davegutz/myThermostat-Particle-Photon/photos/view_of_mechanical_2015-09-09 14.54.21.jpg

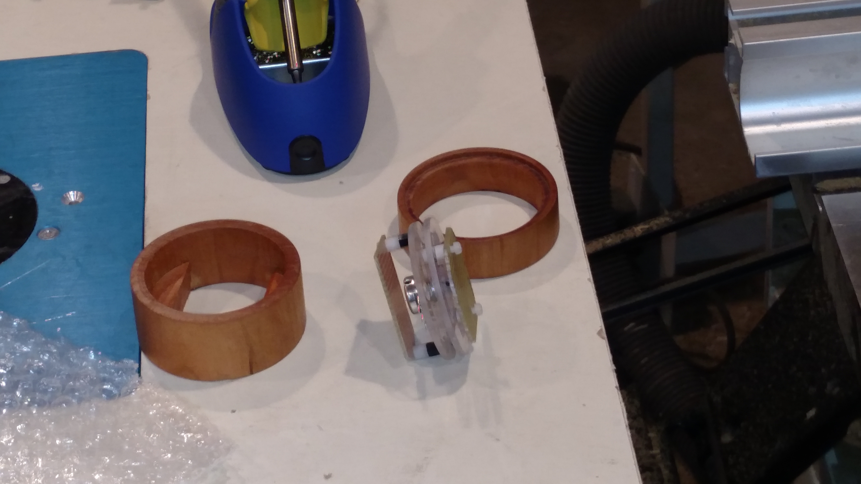
photos/view_of_mechanical_2015-09-09 14.54.21.jpg
