davegutz/myThermostat-Particle-Photon/photos/Working_Photo_IMG_7496.JPG

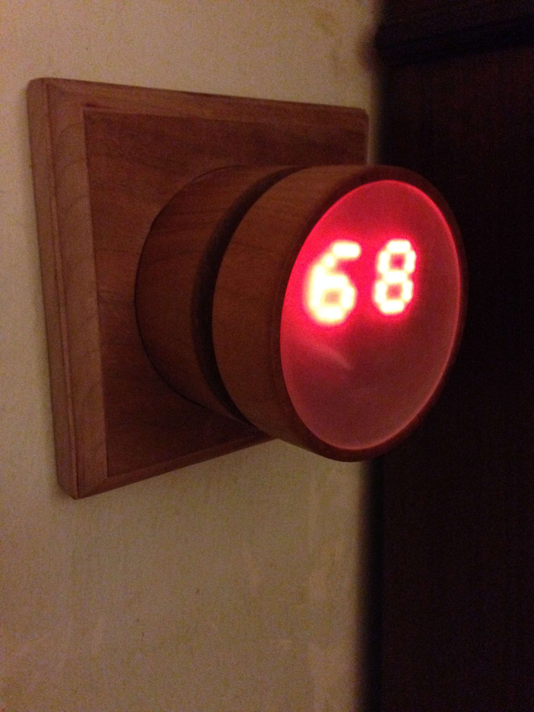
photos/Working_Photo_IMG_7496.JPG
