davegutz/myThermostat-Particle-Photon/schematics/PhotonThermostatLayout.ods

Sheet: Reed SIP Version
 |  |  |  |  |  |  |  |  |  |  |  |  |  |  |  |  |  |  |  |  |  |  |  |  |  |  |  |  |  | Furnace
 |  |  |  |  |  |  |  |  |  |  |  |  |  |  |  |  |  |  |  |  |  |  |  |  |  |  |  |  |  | 1 |  | J-TB4-S32 |  | R
 |  |  | J |  | J30 |  |  | 1-VIN |  |  | 3V3 |  | 24 | J |  | TB7 |  |  |  |  |  |  |  |  |  |  |  |  |  | 2 |  | J-TB4-S33 |  | W
K1 |  |  |  |  | J | e | J31 | 2-GND |  |  | RST |  | 23 | J24 |  | S | --
 | c25 |  | J |  | T1 |  |  | 3-TX |  |  | 3V3 |  | 22 | J24 |  | S | --
 |  |  |  |  | b | 29 |  | 4-RX |  | P1 | GND |  | 21 | J31 |  | S | --
L | J |  |  |  |  | R1 |  | 5-A7 |  |  |  | D7 | 20 | J2 |  | S | -- | PCBs & BreadboardsStripBoard-2, 1 side 80x100mm
 |  |  |  |  |  | Jll |  | 6-A6 |  |  |  | D6 | 19 | J10 |  | S | -- |  |  |  |  |  |  |  |  |  |  |  |  | Rheostat
- | J25 | J26 |  | J28 |  |  |  | 7-A5 |  |  |  | D5 | 18 | J14 |  | S | -- |  |  |  |  |  |  |  |  |  |  |  |  | 1 |  |  | J-TB7-S1orS2
 |  |  |  |  |  |  |  | 8-A4 |  |  |  | D4 | 17 | J13 |  | S | -- |  |  |  |  |  |  |  |  |  |  |  |  | 2 |  |  | J-TB7-S5
+ | J1 |  | S32 |  | -- | JL |  | 9-A3 |  |  |  | D3 | 16 |  |  |  |  |  |  |  |  |  |  |  |  |  |  |  |  | 3 |  |  | J-TB7-S3orS4
 | JL |  | S33 |  | -- |  | J | 10-A2 |  |  |  | D2 | 15 |  |  |  |  |  |  |  |  |  |  |  |  |  |  |  |  | R6
L | J |  | S30 |  | -- | J | J | 11-A1 |  |  |  | D1 | 14 | J
 |  |  | S31 |  | -- | J |  | 12-A0 |  |  |  | D0 | 13 | J
 |  |  |  |  |  |  |  |  |  |  |  |  |  |  |  |  |  |  |  |  |  |  |  |  |  |  |  |  | R2 |  | Pull up resistor for I2C bus 4.7k RC1472KB
 |  |  |  |  |  |  |  |  |  |  |  |  |  |  |  |  |  |  |  |  |  |  |  |  |  |  |  |  | R3 |  | Pull up resistor for I2C bus 4.7k RC1472KB
 |  |  |  |  |  |  |  |  |  |  |  |  |  |  |  |  |  |  |  |  |  |  |  |  |  |  |  |  | TB4 |  | 4-pin terminal block 1725672 4P 2.54mm 90DEG
 |  |  |  |  |  |  |  |  |  |  |  |  | C |  | SCL |  |  |  |  |  | J |  | S9 |  | JR2 |  |  | J-TB7-S6 | S |  | screw
 |  |  |  |  |  |  |  |  |  |  |  |  | D |  | SDA |  |  |  |  |  | J |  | S10 |  | JR3 |  |  | J-TB7-S7 | TB7 |  | 7-pin terminal block 1725708 7P 2.54mm 90DEG
 |  |  |  |  |  |  |  |  |  |  |  |  | G |  | GND |  |  |  | J | J | J |  | S11 |  |  |  |  | J-TB7-S3orS4 | K1 |  | Relay Schneider Reed PCB Magnecraft W117SIP-6
 |  |  |  |  |  |  |  |  |  |  |  |  | V |  | Vin |  |  |  |  | J | J |  | S12 |  | JR2 | JR3 |  | J-TB7-S1orS2 | R6 |  | Rheostat Bourns PDB 181-K220K-103B
 |  |  |  |  |  |  |  |  |  |  |  |  |  |  |  | A2 0x71 |  |  | C1 |  |  | TB4 |  |  | J | R2 | J |  | P1 |  | photon core
 |  |  |  |  |  |  |  |  |  |  |  |  |  |  |  |  |  |  | c | J11 |  |  |  |  | J | R3 | J |  | T1 |  | Transistor 2N2222
 |  |  |  |  |  |  |  |  |  |  |  |  |  |  |  |  |  |  | c | 1 | VCORE |  |  | VDD | 8 | J12 |  |  | C1 |  | Capacitor MLCC 0.1 uF RDER71E104K0K1C03B 25v 10%
 |  |  |  |  |  |  |  |  |  |  |  |  |  |  |  |  |  |  | J11 | 2 | VSS |  |  | NC | 7 |  |  |  | H1H |  | Humidistat with temp SOIC HIH6131-021-001
 |  |  |  |  |  |  |  |  |  |  |  |  | C |  | SCL |  |  |  | J9 | 3 | SCL |  |  | AL_L | 6 |  |  |  | R1 |  | Resistor 330 ohm Carbon 5% RC07GF331J
 |  |  |  |  |  |  |  |  |  |  |  |  | D |  | SDA |  |  |  | J10 | 4 | SDA |  |  | AL_H | 5 |  |  |  | A |  | Adafruit 8x8 LED mini 870 red
 |  |  |  |  |  |  |  |  |  |  |  |  | G |  | GND |  |  |  | J11 |  |  |  | H1H
 |  |  |  |  |  |  |  |  |  |  |  |  | V |  | Vin |  |  |  | J12 |  |  |  |  |  |  |  |  |  |  | Power USB
 |  |  |  |  |  |  |  |  |  |  |  |  |  |  |  | A1 0x70 |  |  |  |  |  |  |  |  |  |  |  |  |  | 5v |  |  | J-TB4-S30
 |  |  |  |  |  |  |  |  |  |  |  |  |  |  |  |  |  |  |  |  |  |  |  |  |  |  |  |  |  | gnd |  |  | J-TB4-S31
 |  |  |  |  |  |  |  |  | This is the version I made that works.

Sheet: SSR version
 |  |  |  |  |  |  |  |  |  |  |  |  |  |  |  |  |  |  |  |  |  |  |  |  |  |  | Furnace
 |  |  |  |  |  |  |  |  |  |  |  |  |  |  |  |  |  |  |  |  |  |  |  |  |  |  | 1 |  | J-TB4-S32
 |  | J | J30 |  |  | 1-VIN |  | 3V3 |  | 24 | J |  | TB7 |  |  |  |  |  |  |  |  |  |  |  |  |  | 2 |  | J-TB4-S33
 |  |  | J | e | J31 | 2-GND |  | RST |  | 23 | J24 |  | S | --
- | c25 |  | T1 |  |  | 3-TX |  | 3V3 |  | 22 | J24 |  | S | --
+ | J1 |  | b | 29 |  | 4-RX | P1 | GND |  | 21 | J31 |  | S | --
K1 |  |  |  | R1 |  | 5-A7 |  |  | D7 | 20 | J2 |  | S | -- | PCBs & BreadboardsStripBoard-2, 1 side 80x100mm
 |  |  |  | J11 |  | 6-A6 |  |  | D6 | 19 | J10 |  | S | -- |  |  |  |  |  |  |  |  |  |  |  |  | Rheostat
 |  | TB4 |  |  |  | 7-A5 |  |  | D5 | 18 | J14 |  | S | -- |  |  |  |  |  |  |  |  |  |  |  |  | 1 |  |  | J-TB7-S1orS2
L | J |  |  |  |  | 8-A4 |  |  | D4 | 17 | J13 |  | S | -- |  |  |  |  |  |  |  |  |  |  |  |  | 2 |  |  | J-TB7-S5
 | J26 | S32 | -- |  |  | 9-A3 |  |  | D3 | 16 |  |  |  |  |  |  |  |  |  |  |  |  |  |  |  |  | 3 |  |  | J-TB7-S3orS4
L |  | S33 | -- |  | J | 10-A2 |  |  | D2 | 15 |  |  |  |  |  |  |  |  |  |  |  |  |  |  |  |  | R6
 |  | S30 | -- | J | J | 11-A1 |  |  | D1 | 14 | J
 |  | S31 | -- | J |  | 12-A0 |  |  | D0 | 13 | J
 |  |  |  |  |  |  |  |  |  |  |  |  |  |  |  |  |  |  |  |  |  |  |  |  |  | R2 |  | Pull up resistor for I2C bus 4.7k RC1472KB
 |  |  |  |  |  |  |  |  |  |  |  |  |  |  |  |  |  |  |  |  |  |  |  |  |  | R3 |  | Pull up resistor for I2C bus 4.7k RC1472KB
^ |  |  |  |  |  |  |  |  |  |  |  |  |  |  |  |  |  |  |  |  |  |  |  |  |  | TB4 |  | 4-pin terminal block 1725672 4P 2.54mm 90DEG
| |  |  |  |  |  |  |  |  |  | C |  | SCL |  |  |  |  |  | J |  | S9 |  | JR2 |  |  | J-TB7-S6 | S |  | screw
| |  |  |  |  |  |  |  |  |  | D |  | SDA |  |  |  |  |  | J |  | S10 |  | JR3 |  |  | J-TB7-S7 | TB7 |  | 7-pin terminal block 1725708 7P 2.54mm 90DEG
SSR |  |  |  |  |  |  |  |  |  | G |  | GND |  |  |  | J | J | J |  | S11 |  |  |  |  | J-TB7-S3orS4 | K1 |  | SSR Relay 4-10v Panasonic LC241R AQG12105
 |  |  |  |  |  |  |  |  |  | V |  | Vin |  |  |  |  | J | J |  | S12 |  | JR2 | JR3 |  | J-TB7-S1orS2 | R6 |  | Rheostat Bourns PDB 181-K220K-103B
 |  |  |  |  |  |  |  |  |  |  |  |  | A2 0x71 |  |  | C1 |  |  | TB4 |  |  | J | R2 | J |  | P1 |  | photon core
 |  |  |  |  |  |  |  |  |  |  |  |  |  |  |  | c | J11 |  |  |  |  | J | R3 | J |  | T1 |  | Transistor 2N2222 |  |  | E
 |  |  |  |  |  |  |  |  |  |  |  |  |  |  |  | c | 1 | VCORE |  |  | VDD | 8 | J12 |  |  | C1 |  | Capacitor MLCC 0.1 uF RDER71E104K0K1C03B 25v 10%
 |  |  |  |  |  |  |  |  |  |  |  |  |  |  |  | J11 | 2 | VSS |  |  | NC | 7 |  |  |  | H1H |  | Humidistat with temp SOIC HIH6131-021-001
 |  |  |  |  |  |  |  |  |  | C |  | SCL |  |  |  | J9 | 3 | SCL |  |  | AL_L | 6 |  |  |  | R1 |  | Resistor 330 ohm Carbon 5% RC07GF331J
 |  |  |  |  |  |  |  |  |  | D |  | SDA |  |  |  | J10 | 4 | SDA |  |  | AL_H | 5 |  |  |  | A |  | Adafruit 8x8 LED mini 870 red
 |  |  |  |  |  |  |  |  |  | G |  | GND |  |  |  | J11 |  |  |  | H1H
 |  |  |  |  |  |  |  |  |  | V |  | Vin |  |  |  | J12 |  |  |  |  |  |  |  |  |  |  | Power USB
 |  |  |  |  |  |  |  |  |  |  |  |  | A1 0x70 |  |  |  |  |  |  |  |  |  |  |  |  |  | 5v |  |  | J-TB4-S30
 |  |  |  |  |  |  |  |  |  |  |  |  |  |  |  |  |  |  |  |  |  |  |  |  |  |  | gnd |  |  | J-TB4-S31
 |  |  |  |  |  | This is the version that appears in Spark Nest Project using SSR

Sheet: Reed SIL version
 |  |  |  |  |  |  |  |  |  |  |  |  |  |  |  |  |  |  |  |  |  |  |  |  |  |  |  |  | Furnace
 |  |  |  |  |  |  |  |  |  |  |  |  |  |  |  |  |  |  |  |  |  |  |  |  |  |  |  |  | 1 |  | J-TB4-S32
 |  |  | J |  | J30 |  |  | 1-VIN |  | 3V3 |  | 24 | J |  | TB7 |  |  |  |  |  |  |  |  |  |  |  |  |  | 2 |  | J-TB4-S33
K1 |  |  |  |  | J | e | J31 | 2-GND |  | RST |  | 23 | J24 |  | S | --
 | c25 |  | J |  | T1 |  |  | 3-TX |  | 3V3 |  | 22 | J24 |  | S | --
L | J |  |  |  | b | 29 |  | 4-RX | P1 | GND |  | 21 | J31 |  | S | --
 |  |  |  |  |  | R1 |  | 5-A7 |  |  | D7 | 20 | J2 |  | S | -- | PCBs & BreadboardsStripBoard-2, 1 side 80x100mm
 |  |  |  |  |  | J11 |  | 6-A6 |  |  | D6 | 19 | J10 |  | S | -- |  |  |  |  |  |  |  |  |  |  |  |  | Rheostat
- | J25 | J26 |  | J28 |  |  |  | 7-A5 |  |  | D5 | 18 | J14 |  | S | -- |  |  |  |  |  |  |  |  |  |  |  |  | 1 |  |  | J-TB7-S1orS2
 |  |  |  |  |  |  |  | 8-A4 |  |  | D4 | 17 | J13 |  | S | -- |  |  |  |  |  |  |  |  |  |  |  |  | 2 |  |  | J-TB7-S5
+ | J1 |  | S32 |  | -- | JL |  | 9-A3 |  |  | D3 | 16 |  |  |  |  |  |  |  |  |  |  |  |  |  |  |  |  | 3 |  |  | J-TB7-S3orS4
 | JL |  | S33 |  | -- |  | J | 10-A2 |  |  | D2 | 15 |  |  |  |  |  |  |  |  |  |  |  |  |  |  |  |  | R6
 |  |  | S30 |  | -- | J | J | 11-A1 |  |  | D1 | 14 | J
L | J |  | S31 |  | -- | J |  | 12-A0 |  |  | D0 | 13 | J
 |  |  |  |  |  |  |  |  |  |  |  |  |  |  |  |  |  |  |  |  |  |  |  |  |  |  |  | R2 |  | Pull up resistor for I2C bus 4.7k RC1472KB
 |  |  |  |  |  |  |  |  |  |  |  |  |  |  |  |  |  |  |  |  |  |  |  |  |  |  |  | R3 |  | Pull up resistor for I2C bus 4.7k RC1472KB
 |  |  |  |  |  |  |  |  |  |  |  |  |  |  |  |  |  |  |  |  |  |  |  |  |  |  |  | TB4 |  | 4-pin terminal block 1725672 4P 2.54mm 90DEG
 |  |  |  |  |  |  |  |  |  |  |  | C |  | SCL |  |  |  |  |  | J |  | S9 |  | JR2 |  |  | J-TB7-S6 | S |  | screw
 |  |  |  |  |  |  |  |  |  |  |  | D |  | SDA |  |  |  |  |  | J |  | S10 |  | JR3 |  |  | J-TB7-S7 | TB7 |  | 7-pin terminal block 1725708 7P 2.54mm 90DEG
 |  |  |  |  |  |  |  |  |  |  |  | G |  | GND |  |  |  | J | J | J |  | S11 |  |  |  |  | J-TB7-S3orS4 | K1 |  | Relay Reed Standex Meder SIL05-1A85-76L3K
 |  |  |  |  |  |  |  |  |  |  |  | V |  | Vin |  |  |  |  | J | J |  | S12 |  | JR2 | JR3 |  | J-TB7-S1orS2 | R6 |  | Rheostat Bourns PDB 181-K220K-103B
 |  |  |  |  |  |  |  |  |  |  |  |  |  |  | A2 0x71 |  |  | C1 |  |  | TB4 |  |  | J | R2 | J |  | P1 |  | photon core
 |  |  |  |  |  |  |  |  |  |  |  |  |  |  |  |  |  | c | J11 |  |  |  |  | J | R3 | J |  | T1 |  | Transistor 2N2222
 |  |  |  |  |  |  |  |  |  |  |  |  |  |  |  |  |  | c | 1 | VCORE |  |  | VDD | 8 | J12 |  |  | C1 |  | Capacitor MLCC 0.1 uF RDER71E104K0K1C03B 25v 10%
 |  |  |  |  |  |  |  |  |  |  |  |  |  |  |  |  |  | J11 | 2 | VSS |  |  | NC | 7 |  |  |  | H1H |  | Humidistat with temp SOIC HIH6131-021-001
 |  |  |  |  |  |  |  |  |  |  |  | C |  | SCL |  |  |  | J9 | 3 | SCL |  |  | AL_L | 6 |  |  |  | R1 |  | Resistor 330 ohm Carbon 5% RC07GF331J
 |  |  |  |  |  |  |  |  |  |  |  | D |  | SDA |  |  |  | J10 | 4 | SDA |  |  | AL_H | 5 |  |  |  | A |  | Adafruit 8x8 LED mini 870 red
 |  |  |  |  |  |  |  |  |  |  |  | G |  | GND |  |  |  | J11 |  |  |  | H1H
 |  |  |  |  |  |  |  |  |  |  |  | V |  | Vin |  |  |  | J12 |  |  |  |  |  |  |  |  |  |  | Power USB
 |  |  |  |  |  |  |  |  |  |  |  |  |  |  | A1 0x70 |  |  |  |  |  |  |  |  |  |  |  |  |  | 5v |  |  | J-TB4-S30
 |  |  |  |  |  |  |  |  |  |  |  |  |  |  |  |  |  |  |  |  |  |  |  |  |  |  |  |  | gnd |  |  | J-TB4-S31
 |  |  |  |  |  |  |  | This is exactly like the version I made that works but with different
 |  |  |  |  |  |  |  | brand of Reed Relay.
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
