davegutz/myThermostat-Particle-Photon/dataSheets/thermostat-v100.png

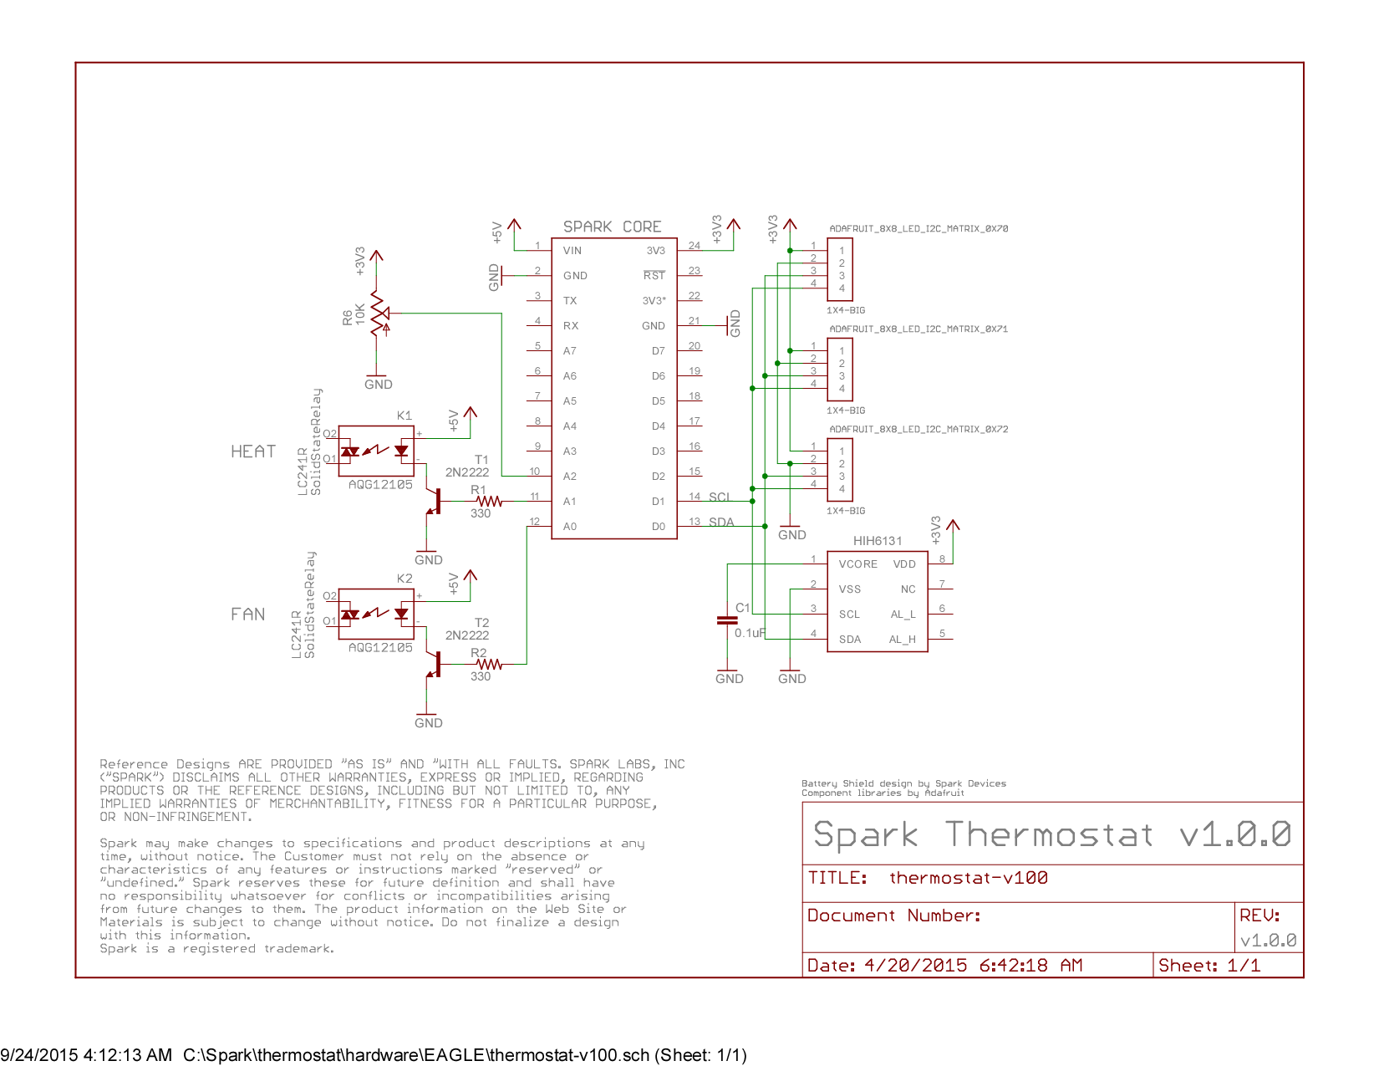
dataSheets/thermostat-v100.png
