davegutz/myThermostat-Particle-Photon/dataSheets/veroSheet.png

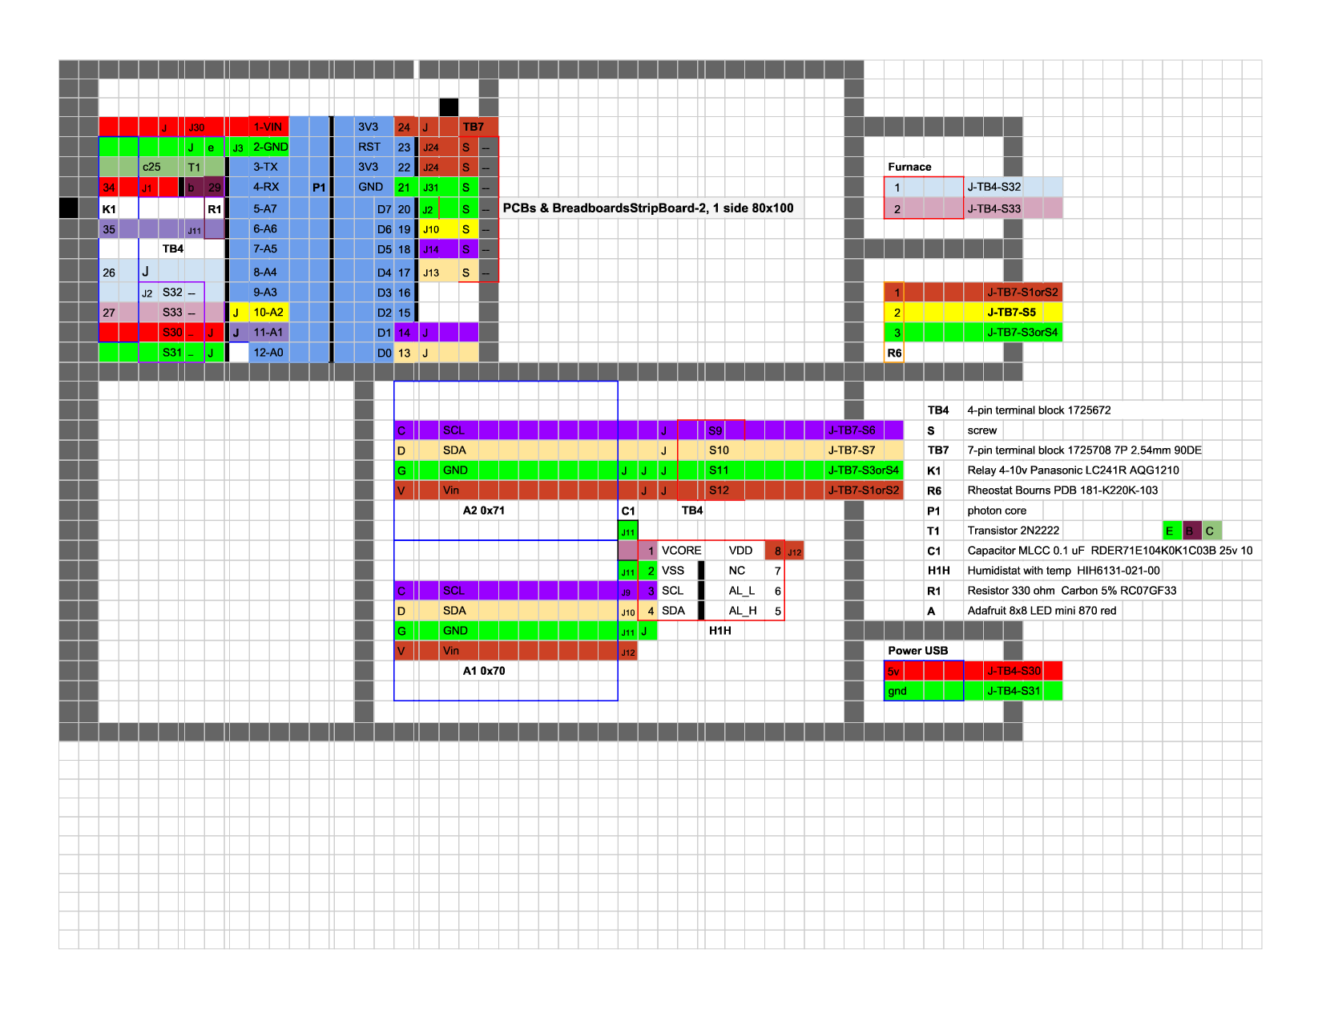
dataSheets/veroSheet.png
