davegutz/myThermostat-Particle-Photon/photos/view_of_backside_wall_mount_2015-10-31 10.32.52.jpg

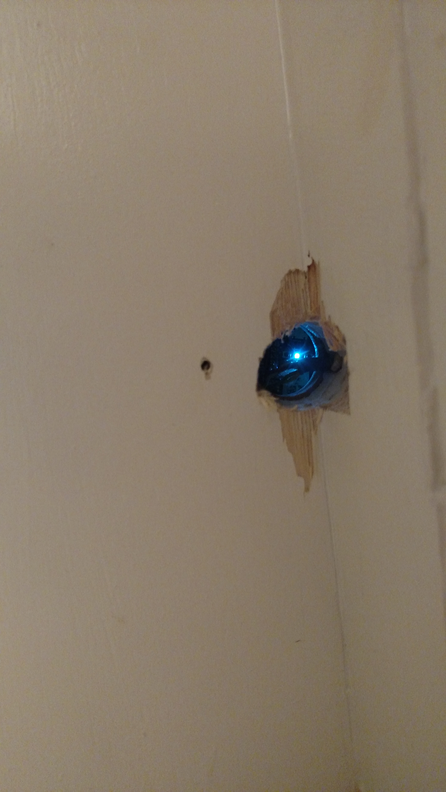
photos/view_of_backside_wall_mount_2015-10-31 10.32.52.jpg
