davegutz/myThermostat-Particle-Photon/photos/view_of_BlynkPage.png

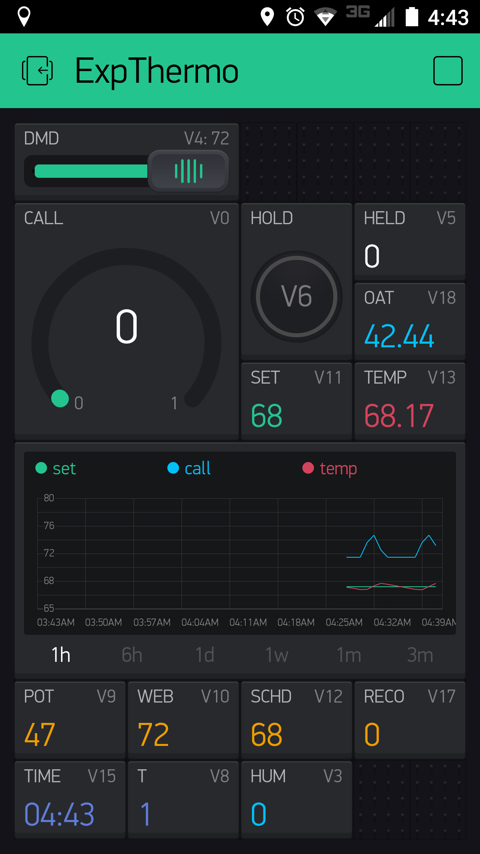
photos/view_of_BlynkPage.png
