davegutz/myThermostat-Particle-Photon/photos/view_of_wall_mount_2015-10-31 10.32.13.jpg

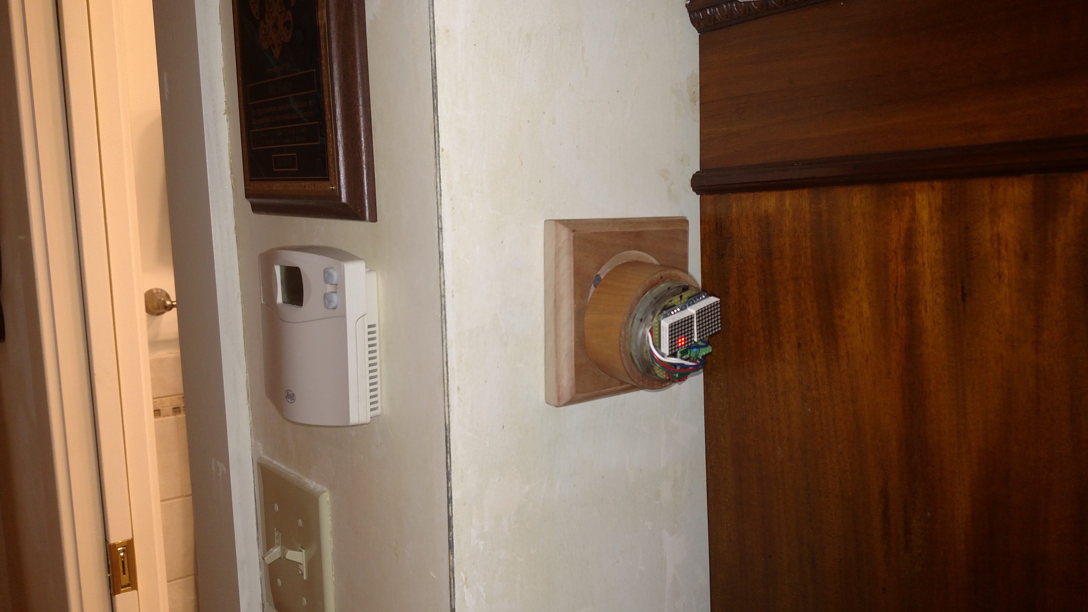
photos/view_of_wall_mount_2015-10-31 10.32.13.jpg
