davegutz/myThermostat-Particle-Photon/myScheduledThermostat-Prototype/myScheduledThermostat.ino

// myScheduledThermostat.ino
// Control home heating (not cooling) with a potentiometer, a web interface
// (Blynk), and by schedules.  This is written for a Particle Photon
// target.  The electrical schematic is the same as the Spark Nest Thermostat
// project with I2C 4.7K pullup resistors added and the solid state relay swapped out for
// a Reed relay to control a Triangle Tube Prestige furnace interface (Honeywell
// dial thermostat compatible).
//
/*  TODO:::::::::::::::::::
-   Checkout using other Photon
-   Plot CALL on Blynk as 73-75 F
-   Floating point control law
-   Wait 5 sec before turning CALL on, to filter out fumbling hands
-   Display Time on Blynk instead of HOURS.
-   Display DAY on Blynk
-   Get OAT in prep for RECO function
*/
//
// Requirements:
// 1.   Read temperature.
// 2.   Determine setpoint and turn on furnace relay when temperature < setpoint.  Turn off relay when temperature
//      reaches setpoint.
// 3.   Read potentiometer POT and set a demand based on the reading.
// 4.   Read Blynk Web demanded temperature WEB and set a demand based on the reading.
// 5.   Read Blynk Web over-ride and disable the schedule and web demand functions as long as latched.
// 6.   Schedule 4 changes in all 7 days of the week.   When time reaches a change
//      table time instantly change demand to the change table temperature and hold.
// 7.   Potentiometer is physically present and must always win if it is most recent change of
//      setpoint.
// 8.   The Blynk Web is needed to set temperature remotely for some reason and must win over the
//      schedule but only if demanded so.
// 9.   Following power loss the functions must return to the exact settings.
// 10.  Automatically change with daylight savings (this is built into SparkTime as default)
// 
// Nomenclature:
// CALL     Call for heat, boolean
// SET      Temperature setpoint of thermostat, F
// TEMP     Measured temperature, F
// HUM      Measured humidity, %
// DMD      Temperature setpoint demanded by web, F
// HELD     Confirmation of web HOLD demand, boolean
// HOLD     Web HOLD demand, boolean
// HOUR     Time being used by this program for troubleshooting, hours
// POT      The pot reading converted to degrees demand, F
// WEB      The Web temperature demand, F
// SCHD     The time-scheduled setpoint stored in tables, F
// T        Control law update time, sec
//
// On your Blynk app:
//   0. Connect a green LED or 0-1 gage to V0 (CALL)
//   1. Connect a green numerical 50-72 display to V1 (SET)
//   2. Connect a red 40-100 gage to V2 (TEMP)
//   3. Connect a blue numerical 0-100 display to V3 (HUM)
//   4. Connect a green 50-72 slider to V4 (DMD)
//   5. Connect a white numerical 0-1 display to V5 (HELD)
//   6. Connect a white switch to V6 (HOLD)
//   7. Connect a purple numerical 0-200 display to V7 (HOUR)
//   8. Connect a purple numerical 0-200 display to V8 (T)
//   9. Connect an orange numerical 50-72 display to V9 (POT)
//  10. Connect an orange numerical 50-72 display to V10 (WEB)
//  11. Connect a green numerical 50-72 display to V11 (SET)
//  12. Connect an orange numerical 50-72 display to V12 (SCHD)
//  13. Connect a red numerical 30-100 display to V13 (TEMP)
//
// 23-Oct-2015  DA Gutz     Created
//
// Dependencies:  ADAFRUIT-LED-BACKPACK, SPARKTIME, SPARKINTERVALTIMER, BLYNK,
//                 blynk app account, Particle account
// 
//#pragma SPARK_NO_PREPROCESSOR
#include "application.h"
#include "adafruit-led-backpack/adafruit-led-backpack.h"
#include "SparkIntervalTimer/SparkIntervalTimer.h"
#include "SparkTime/SparkTime.h"
#include "blynk/blynk.h"
#include "blynk/BlynkHandlers.h"
#include <math.h>
//#define BLYNK_DEBUG // Optional, this enables lots of prints
//#define BLYNK_PRINT Serial
#define controlDelay    1000                // Control law wait, ms
#define publishDelay    20000               // Time between cloud updates, ms
#define readDelay       5000                // Sensor read wait, ms
#define DESIRED_TEMP_FLASH_ADDRESS 0x80000  // Flash temp address
#undef  FAKETIME                            // For simulating rapid time passing
#define HEAT_PIN    A1                      // Heat relay output pin on Photon
#define HYST    1                           // Heat control law hysteresis, F
#define POT_PIN     A2                      // Potentiometer input pin on Photon
#define TEMP_SENSOR 0x27                    // Temp sensor bus address
#define TEMPCAL -4                          // Calibrate temp sense, F
#define MINSET  50                          // Minimum setpoint allowed, F
#define MAXSET  72                          // Maximum setpoint allowed, F
#define NCH     4                           // Number of temp changes in daily sched
enum    Mode {POT, WEB, SCHD};              // To keep track of mode
char                blynkAuth[]     = "key here";
bool                call            = false;// Heat demand to relay control
Mode                controlMode     = POT;  // Present control mode
int                 displayTime     = 10000;// Elapsed time display LED
int                 EEPROM_ADDR     = 10;   // Flash address
bool                held            = false;// Web toggled permanent and acknowledged
int                 hum             = 0;    // Relative humidity integer value, %
int                 I2C_Status      = 0;    // Bus status
bool                lastHold        = false;// Web toggled permanent and acknowledged
int                 LED             = D7;   // Status LED
Adafruit_8x8matrix  matrix1;                // Tens LED matrix
Adafruit_8x8matrix  matrix2;                // Ones LED matrix
IntervalTimer       myTimer;                // To dim display
IntervalTimer       myTimer7;               // To blink LED
int                 potValue        = 0;    // Dial raw value, F
SparkTime           rtc;                    // Time value
int                 schdDmd         = 0;    // Sched raw value, F
int                 set             = 62;   // Selected sched, F
double              temp            = 0.0;  // Sensed temp, F
int                 tempInt         = 0;    // Sensed integer temperature, F
UDP                 UDPClient;              // Time structure
double              updateTime;             // Control law update time, sec
static const int    verbose         = 2;    // Debug, as much as you can tolerate
uint8_t             webDmd          = 62;   // Web sched, F
bool                webHold         = false;// Web permanence request

// Schedules
bool hourChErr = false;
// Time to trigger setting change
static float hourCh[7][NCH] = {
    6, 8, 16, 22,   // Sun
    4, 7, 16, 22,   // Mon
    4, 7, 16, 22,   // Tue
    4, 7, 16, 22,   // Wed
    4, 7, 16, 22,   // Thu
    4, 7, 16, 22,   // Fri
    6, 8, 16, 22    // Sat
};
// Temp setting after change in above table.   Change holds until next
// time trigger.  Over-ridden either by pot or web adjustments.
static const float tempCh[7][NCH] = {
    68, 62, 68, 62, // Sun
    68, 62, 68, 62, // Mon
    68, 62, 68, 62, // Tue
    68, 62, 68, 62, // Wed
    68, 62, 68, 62, // Thu
    68, 62, 68, 62, // Fri
    68, 62, 68, 62  // Sat
};

// Handler for the display dimmer timer, called automatically
void OnTimerDim(void)
{
    matrix1.clear();
    matrix2.clear();
    if (!call)
    {
        matrix1.setCursor(1, 0);
        matrix1.write('.');
    }
    else
    {
        matrix2.setCursor(1, 0);
        matrix2.write('+');
    }
    matrix1.setBrightness(1);  // 1-15
    matrix2.setBrightness(1);  // 1-15
    matrix1.writeDisplay();
    matrix2.writeDisplay();
}

// Display the temperature setpoint on LED matrices.   All the ways to set temperature
// are displayed on the matrices.  It's cool to see the web and schedule adjustments change
// the display briefly.
void displayTemperature(void)
{
    char ones = abs(set) % 10;
    char tens =(abs(set) / 10) % 10;
    /*
    uint8_t smile[] = {
        0b00111100,
        0b01000010,
        0b10100101,
        0b10000001,
        0b10100101,
        0b10011001,
        0b01000010,
        0b00111100
    };
    */
    matrix1.clear();
    matrix1.setCursor(0, 0);
    matrix1.write(tens + '0');
    //matrix1.drawBitmap(0, 0, smile, 8, 8, LED_ON);
    matrix1.setBrightness(1);  // 1-15
    matrix1.blinkRate(0);      // 0-3
    matrix1.writeDisplay();
    matrix2.clear();
    matrix2.setCursor(0, 0);
    matrix2.write(ones + '0');
    matrix2.setBrightness(1);  // 1-15
    matrix2.blinkRate(0);      // 0-3
    matrix2.writeDisplay();
    // Reset clock
    myTimer.resetPeriod_SIT(displayTime, hmSec);
}

// Save temperature setpoint to flash for next startup.   During power
// failures the thermostat will reset to the condition it was in before
// the power failure.
void saveTemperature()
{
    uint8_t values[3] = { (uint8_t)set, (uint8_t)held, (uint8_t)webDmd };
    EEPROM.put(EEPROM_ADDR, values);
}

// Load the saved temperature setting so pickup where left off after power failure
void loadTemperature()
{
    Serial.println("Loading and displaying temperature from flash");
    uint8_t values[3];
    EEPROM.get(EEPROM_ADDR, values);
    set     = values[0];
    displayTemperature();
    webHold = values[1];
    webDmd  = values[2];
}

// Process a new temperature setting.   Display and save it.
int setTemperature(int t)
{
    set = t;
    switch(controlMode)
    {
        case POT:   displayTemperature();   break;
        case WEB:   break;
        case SCHD:  break;
    }
    saveTemperature();
    return set;
}

// Setup LEDs
void setupMatrix(Adafruit_8x8matrix m)
{
    m.clear();
    m.writeDisplay();
    m.setTextSize(1);
    m.setTextWrap(false);
    m.setTextColor(LED_ON);
    m.setRotation(0);
    m.setCursor(0, 0);
}

// Convert time to decimal for easy lookup
double decimalTime(unsigned long *currentTime)
{
    *currentTime = rtc.now(); 
    #ifndef FAKETIME
        uint8_t dayOfWeek = rtc.dayOfWeek(*currentTime); 
        uint8_t hours     = rtc.hour(*currentTime);
        uint8_t minutes   = rtc.minute(*currentTime);
        uint8_t seconds   = rtc.second(*currentTime);
    #else
        // Rapid time passage simulation to test schedule functions
        uint8_t dayOfWeek = rtc.minute(*currentTime)*7/6;      // minutes = days
        uint8_t hours     = rtc.second(*currentTime)*24/60;    // seconds = hours
        uint8_t minutes   = 0;                                // forget minutes
        uint8_t seconds   = 0;                                // forget seconds
    #endif
    return( float(dayOfWeek)*24.0 + float(hours) + float(minutes)/60.0 + \
                        float(seconds)/3600.0 );  // 0-6 days and 0 is Sunday
}

// Find time in schedule
double scheduledTemp(double hourDecimal)
{
    // Find spot in schedules
    int day = hourDecimal/24;  // Day known apriori
    int num;
    if ( ((day==0) & (hourDecimal< hourCh[0][0]))   |\
         ((day==6) & (hourDecimal>=hourCh[day][NCH-1])) )
    {
        day = 6;
        num = NCH-1;
    }
    else
    {
        int i;
        for (i=0; i<7*NCH; i++)
        {
            day = i/NCH;
            num = i-day*NCH;
            if ( !(hourDecimal>hourCh[day][num]) )
            {
                i--;
                day = i/NCH;
                num = i-day*NCH;
                break;
            }
        }
    }
    return (tempCh[day][num]);
}
  
  // Attach a Slider widget to the Virtual pin 4 in your Blynk app - and control the web desired temperatuer
BLYNK_WRITE(V4) {
    if (param.asInt() > 0)
    {
        webDmd = (uint8_t)param.asDouble();
    }
}

// Attach a switch widget to the Virtual pin 6 in your Blynk app - and demand continuous web control
BLYNK_WRITE(V6) {
    webHold = param.asInt();
}

// Setup
void setup()
{
    Wire.setSpeed(CLOCK_SPEED_100KHZ);
    Wire.begin();
    pinMode(LED, OUTPUT);               // sets pin as output
    matrix1.begin(0x70);
    matrix2.begin(0x71);
    setupMatrix(matrix1);
    setupMatrix(matrix2);
    Particle.variable("call",       &call,                  BOOLEAN);
    Particle.variable("temp",       &temp,                  DOUBLE);
    Particle.variable("hum",        &hum,                   INT);
    Particle.variable("pot",        &potValue,              INT);
    Particle.variable("temp",       &tempInt,               INT);
    Particle.variable("set",        &set,                   INT);
    Particle.variable("stat",       &I2C_Status,            INT);
    loadTemperature();
    pinMode(HEAT_PIN,   OUTPUT);
    pinMode(POT_PIN,    INPUT);
    myTimer.begin(OnTimerDim, displayTime, hmSec);

    // Time schedule convert and check
    rtc.begin(&UDPClient, "pool.ntp.org");
    rtc.setTimeZone(-5); // gmt offset
    for (int day=0; day<7; day++) for (int num=0; num<NCH; num++)
    {
        if (hourCh[day][num] > 24) hourChErr = true;
        hourCh[day][num] = hourCh[day][num] + float(day)*24.0;
    }
    for (int day=0; day<7; day++) for (int num=0; num<(NCH-1); num++)
    {
        if (hourCh[day][num] >= hourCh[day][num+1]) hourChErr = true;
    }
    
    // Begin
    Serial.begin(9600);
    delay(1000); // Allow board to settle
    Blynk.begin(blynkAuth);
}

// Loop
void loop()
{
    unsigned long       currentTime;        // Time result
    unsigned long       now = millis();     // Keep track of time
    double              hour;               // Decimal time, hour
    int                 potDmd   = 0;       // Pot value, deg F
    bool                control;            // Control sequence, T/F
    bool                publish;            // Publish, T/F
    bool                read;               // Read, T/F
    static double       lastHour    = 0.0;  // Past used time value,  hours
    static unsigned int lastControl = 0;    // Last control law time, ms
    static unsigned int lastPublish = 0;    // Last publish time, ms
    static unsigned int lastRead    = 0;    // Last read time, ms


    // Sequencing
    Blynk.run();
    control = (now-lastControl) >= controlDelay;
    publish = (now-lastPublish) >= publishDelay;
    read    = (now-lastRead)    >= readDelay;
    if ( control ) lastControl  = now;
    if ( publish ) lastPublish  = now;
    if ( read )    lastRead     = now;
    
    // Read sensors
    if ( read )
    {
        Wire.beginTransmission(TEMP_SENSOR);
        Wire.endTransmission();
        delay(40);
        Wire.requestFrom(TEMP_SENSOR, 4);
        Wire.write(byte(0));
        uint8_t b   = Wire.read();
        I2C_Status  = b >> 6;
        //
        int rawHum  = (b << 8) & 0x3f00;
        rawHum      |=Wire.read();
        hum         = roundf(rawHum / 163.83);
        //
        int rawTemp = (Wire.read() << 6) & 0x3fc0;
        rawTemp     |=Wire.read() >> 2;
        temp        = (float(rawTemp)*165.0/16383.0 - 40.0)*1.8 + 32.0 + TEMPCAL; // convert to fahrenheit and calibrate
        tempInt     = roundf(temp);
    }


    // Interrogate pot
    // my pot puts out 2872 - 4088 observed using following
    potValue    = 4095 - analogRead(POT_PIN);
    potDmd      = roundf((float(potValue)-2872)/(4088-2872)*26+47);

    // Calculate time
    hour = decimalTime(&currentTime);

    // Interrogate schedule
    if ( read )   schdDmd = scheduledTemp(hour);


    // Scheduling logic
    // 1.  Pot has highest priority
    //     a.  Pot will not hold past next schedule change
    //     b.  Web change will override it
    // 2.  Web Blynk has next highest priority
    //     a.  Web will hold only if HOLD is on
    //     b.  Web will HOLD indefinitely.
    //     c.  When Web is HELD, all other inputs are ignored
    // 3.  Finally the schedule gets it's say
    //     a.  Holds last number until time at next change
    //
    // Notes:  
    // i.  webDmd is transmitted by Blynk to Photon only when it changes
    // ii. webHold is transmitted periodically by Blynk to Photon

    // Initialize scheduling logic - don't change on boot
    static int      lastChangedPot      = potValue;
    static uint8_t  lastChangedWebDmd   = webDmd;
    static int      lastChangedSched    = schdDmd;


    // If user has adjusted the potentiometer (overrides schedule until next schedule change)
    // Use potValue for checking because it has more resolution than the integer potDmd
    if ( fabsf(potValue-lastChangedPot)>16 )  // adjust from 64 because my range is 1214 not 4095
    {
        controlMode     = POT;
        int t = min(max(MINSET, potDmd), MAXSET);
        setTemperature(t);
        held = false;  // allow the pot to override the web demands.  HELD allows web to override schd.
        if (verbose>0) Serial.printf("Setpoint based on pot:  %ld\n", t);
        lastChangedPot = potValue;
    } 
    //
    // Otherwise if web Blynk has adjusted setpoint (overridden temporarily by pot, until next web adjust)
    // The held construct ensures that temp setting latched in by HOLD in Blynk cannot be accidentally changed
    // The webHold construct ensures that pushing HOLD in Blynk causes control to snap to the web demand
    else if ( ((abs(webDmd-lastChangedWebDmd)>0)  & (!held)) | (webHold & (webHold!=lastHold)) )
    {
        controlMode     = WEB;
        int t = min(max(MINSET, webDmd), MAXSET);   
        setTemperature(t);
        if (verbose>0) Serial.printf("Setpoint based on web:  %ld\n", t);
        lastChangedWebDmd   = webDmd;
    }
    // Otherwise if schedule has adjusted setpoint (overridden temporarily by pot or web, until next schd adjust)
    else if (fabsf(schdDmd-lastChangedSched)>0 & (!held) )
    {
        controlMode     = SCHD;
        int t = min(max(MINSET, schdDmd), MAXSET);   
        if (hourChErr)
        {
            Serial.println("***Table error, ignoring****");
        }
        else 
        {
            setTemperature(t);
            if (verbose>0) Serial.printf("Setpoint based on schedule:  %ld\n", t);
        }
        lastChangedSched = schdDmd;
    } 
    if (webHold!=lastHold)
    {
        lastHold    = webHold;
        held        = webHold;
        saveTemperature();
    }

    // Control law.   Simple on/off but update time structure ('control' calculation) provided for
    // dynamic logic when needed
    if ( control )
    {
        updateTime  = (hour - lastHour)*3600.0;
        lastHour    = hour;
        if ( call )
        {
            call    = (set + HYST) > tempInt;
        }
        else
        {
            call    = set > tempInt;
        }
        digitalWrite(HEAT_PIN, call);
        digitalWrite(LED, call);
    } 


    // Publish
    if ( publish )
    {
        if (verbose>1) Serial.printf("V0=%ld | V1=%ld | V2=%f | V3=%ld | V4=%u | V5=%ld | V6=%ld | V7=%f | V8=%f | V9=%ld | V10=%ld | V11=%ld | V12=%ld | V13=%f | V14=%ld\n", \
            call, set, temp, hum, webDmd, held, webHold, hour, updateTime, potDmd, lastChangedWebDmd, set, schdDmd, temp, I2C_Status);
        if ( Particle.connected() )
        {
            Blynk.virtualWrite(V0,  call);
            Blynk.virtualWrite(V1,  set);
            Blynk.virtualWrite(V2,  temp);
            Blynk.virtualWrite(V3,  hum);
            Blynk.virtualWrite(V5,  held);
            Blynk.virtualWrite(V7,  hour);
            Blynk.virtualWrite(V8,  updateTime);
            Blynk.virtualWrite(V9,  potDmd);
            Blynk.virtualWrite(V10, lastChangedWebDmd);
            Blynk.virtualWrite(V11, set);
            Blynk.virtualWrite(V12, schdDmd);
            Blynk.virtualWrite(V13, temp);
            Blynk.virtualWrite(V14, I2C_Status);
        }  
    } 

}  // loop
