davegutz/myThermostat-Particle-Photon/myThermostat_Particle_DEV/BlynkHandlers.cpp

/**
 * @file       BlynkHandlers.cpp
 * @author     Volodymyr Shymanskyy
 * @license    This project is released under the MIT License (MIT)
 * @copyright  Copyright (c) 2015 Volodymyr Shymanskyy
 * @date       Jan 2015
 * @brief      Virtual pin utilities
 */

//#include <Blynk/BlynkConfig.h>
//#include <Blynk/BlynkHandlers.h>
//#include <Blynk/BlynkDebug.h>
#include "BlynkConfig.h"
#include "BlynkHandlers.h"
#include "BlynkDebug.h"

void BlynkNoOpCbk()
{}

void BlynkWidgetRead(BlynkReq& request)
{
    BLYNK_LOG2(BLYNK_F("No handler for reading from pin "), request.pin);
}

void BlynkWidgetWrite(BlynkReq& request, const BlynkParam& param)
{
    BLYNK_LOG2(BLYNK_F("No handler for writing to pin "), request.pin);
}

#define BLYNK_ON_READ_IMPL(pin)  void BlynkWidgetRead  ## pin (BlynkReq& req) \
          __attribute__((weak, alias("BlynkWidgetRead")))

#define BLYNK_ON_WRITE_IMPL(pin) void BlynkWidgetWrite ## pin (BlynkReq& req, const BlynkParam& param) \
          __attribute__((weak, alias("BlynkWidgetWrite")))

BLYNK_CONNECTED() __attribute__((weak, alias("BlynkNoOpCbk")));
BLYNK_DISCONNECTED() __attribute__((weak, alias("BlynkNoOpCbk")));

BLYNK_ON_READ_IMPL(Default);
BLYNK_ON_WRITE_IMPL(Default);

BLYNK_ON_READ_IMPL(0 );
BLYNK_ON_READ_IMPL(1 );
BLYNK_ON_READ_IMPL(2 );
BLYNK_ON_READ_IMPL(3 );
BLYNK_ON_READ_IMPL(4 );
BLYNK_ON_READ_IMPL(5 );
BLYNK_ON_READ_IMPL(6 );
BLYNK_ON_READ_IMPL(7 );
BLYNK_ON_READ_IMPL(8 );
BLYNK_ON_READ_IMPL(9 );
BLYNK_ON_READ_IMPL(10);
BLYNK_ON_READ_IMPL(11);
BLYNK_ON_READ_IMPL(12);
BLYNK_ON_READ_IMPL(13);
BLYNK_ON_READ_IMPL(14);
BLYNK_ON_READ_IMPL(15);
BLYNK_ON_READ_IMPL(16);
BLYNK_ON_READ_IMPL(17);
BLYNK_ON_READ_IMPL(18);
BLYNK_ON_READ_IMPL(19);
BLYNK_ON_READ_IMPL(20);
BLYNK_ON_READ_IMPL(21);
BLYNK_ON_READ_IMPL(22);
BLYNK_ON_READ_IMPL(23);
BLYNK_ON_READ_IMPL(24);
BLYNK_ON_READ_IMPL(25);
BLYNK_ON_READ_IMPL(26);
BLYNK_ON_READ_IMPL(27);
BLYNK_ON_READ_IMPL(28);
BLYNK_ON_READ_IMPL(29);
BLYNK_ON_READ_IMPL(30);
BLYNK_ON_READ_IMPL(31);
#ifdef BLYNK_USE_128_VPINS
  BLYNK_ON_READ_IMPL(32);
  BLYNK_ON_READ_IMPL(33);
  BLYNK_ON_READ_IMPL(34);
  BLYNK_ON_READ_IMPL(35);
  BLYNK_ON_READ_IMPL(36);
  BLYNK_ON_READ_IMPL(37);
  BLYNK_ON_READ_IMPL(38);
  BLYNK_ON_READ_IMPL(39);
  BLYNK_ON_READ_IMPL(40);
  BLYNK_ON_READ_IMPL(41);
  BLYNK_ON_READ_IMPL(42);
  BLYNK_ON_READ_IMPL(43);
  BLYNK_ON_READ_IMPL(44);
  BLYNK_ON_READ_IMPL(45);
  BLYNK_ON_READ_IMPL(46);
  BLYNK_ON_READ_IMPL(47);
  BLYNK_ON_READ_IMPL(48);
  BLYNK_ON_READ_IMPL(49);
  BLYNK_ON_READ_IMPL(50);
  BLYNK_ON_READ_IMPL(51);
  BLYNK_ON_READ_IMPL(52);
  BLYNK_ON_READ_IMPL(53);
  BLYNK_ON_READ_IMPL(54);
  BLYNK_ON_READ_IMPL(55);
  BLYNK_ON_READ_IMPL(56);
  BLYNK_ON_READ_IMPL(57);
  BLYNK_ON_READ_IMPL(58);
  BLYNK_ON_READ_IMPL(59);
  BLYNK_ON_READ_IMPL(60);
  BLYNK_ON_READ_IMPL(61);
  BLYNK_ON_READ_IMPL(62);
  BLYNK_ON_READ_IMPL(63);
  BLYNK_ON_READ_IMPL(64);
  BLYNK_ON_READ_IMPL(65);
  BLYNK_ON_READ_IMPL(66);
  BLYNK_ON_READ_IMPL(67);
  BLYNK_ON_READ_IMPL(68);
  BLYNK_ON_READ_IMPL(69);
  BLYNK_ON_READ_IMPL(70);
  BLYNK_ON_READ_IMPL(71);
  BLYNK_ON_READ_IMPL(72);
  BLYNK_ON_READ_IMPL(73);
  BLYNK_ON_READ_IMPL(74);
  BLYNK_ON_READ_IMPL(75);
  BLYNK_ON_READ_IMPL(76);
  BLYNK_ON_READ_IMPL(77);
  BLYNK_ON_READ_IMPL(78);
  BLYNK_ON_READ_IMPL(79);
  BLYNK_ON_READ_IMPL(80);
  BLYNK_ON_READ_IMPL(81);
  BLYNK_ON_READ_IMPL(82);
  BLYNK_ON_READ_IMPL(83);
  BLYNK_ON_READ_IMPL(84);
  BLYNK_ON_READ_IMPL(85);
  BLYNK_ON_READ_IMPL(86);
  BLYNK_ON_READ_IMPL(87);
  BLYNK_ON_READ_IMPL(88);
  BLYNK_ON_READ_IMPL(89);
  BLYNK_ON_READ_IMPL(90);
  BLYNK_ON_READ_IMPL(91);
  BLYNK_ON_READ_IMPL(92);
  BLYNK_ON_READ_IMPL(93);
  BLYNK_ON_READ_IMPL(94);
  BLYNK_ON_READ_IMPL(95);
  BLYNK_ON_READ_IMPL(96);
  BLYNK_ON_READ_IMPL(97);
  BLYNK_ON_READ_IMPL(98);
  BLYNK_ON_READ_IMPL(99);
  BLYNK_ON_READ_IMPL(100);
  BLYNK_ON_READ_IMPL(101);
  BLYNK_ON_READ_IMPL(102);
  BLYNK_ON_READ_IMPL(103);
  BLYNK_ON_READ_IMPL(104);
  BLYNK_ON_READ_IMPL(105);
  BLYNK_ON_READ_IMPL(106);
  BLYNK_ON_READ_IMPL(107);
  BLYNK_ON_READ_IMPL(108);
  BLYNK_ON_READ_IMPL(109);
  BLYNK_ON_READ_IMPL(110);
  BLYNK_ON_READ_IMPL(111);
  BLYNK_ON_READ_IMPL(112);
  BLYNK_ON_READ_IMPL(113);
  BLYNK_ON_READ_IMPL(114);
  BLYNK_ON_READ_IMPL(115);
  BLYNK_ON_READ_IMPL(116);
  BLYNK_ON_READ_IMPL(117);
  BLYNK_ON_READ_IMPL(118);
  BLYNK_ON_READ_IMPL(119);
  BLYNK_ON_READ_IMPL(120);
  BLYNK_ON_READ_IMPL(121);
  BLYNK_ON_READ_IMPL(122);
  BLYNK_ON_READ_IMPL(123);
  BLYNK_ON_READ_IMPL(124);
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
    BlynkWidgetWrite108,  BlynkWidgetWrite109,  BlynkWidgetWrite110,  BlynkWidgetWrite111,
    BlynkWidgetWrite112,  BlynkWidgetWrite113,  BlynkWidgetWrite114,  BlynkWidgetWrite115,
    BlynkWidgetWrite116,  BlynkWidgetWrite117,  BlynkWidgetWrite118,  BlynkWidgetWrite119,
    BlynkWidgetWrite120,  BlynkWidgetWrite121,  BlynkWidgetWrite122,  BlynkWidgetWrite123,
    BlynkWidgetWrite124,  BlynkWidgetWrite125,  BlynkWidgetWrite126,  BlynkWidgetWrite127,
#endif
};

WidgetReadHandler GetReadHandler(uint8_t pin)
{
    if (pin >= COUNT_OF(BlynkReadHandlerVector))
        return NULL;
#ifdef BLYNK_HAS_PROGMEM
    return (WidgetReadHandler)pgm_read_word(&BlynkReadHandlerVector[pin]);
#else
    return BlynkReadHandlerVector[pin];
#endif
}

WidgetWriteHandler GetWriteHandler(uint8_t pin)
{
    if (pin >= COUNT_OF(BlynkWriteHandlerVector))
        return NULL;
#ifdef BLYNK_HAS_PROGMEM
    return (WidgetWriteHandler)pgm_read_word(&BlynkWriteHandlerVector[pin]);
#else
    return BlynkWriteHandlerVector[pin];
#endif
}
