davegutz/myThermostat-Particle-Photon/myThermostat_Particle_DEV/SparkIntervalTimer.cpp

/* Copyright (c) 2014 Paul Kourany, based on work by Dianel Gilbert

UPDATED Sept 3, 2015 - Added support for Particle Photon

Copyright (c) 2013 Daniel Gilbert, loglow@gmail.com

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
THE SOFTWARE IS PROVIDED "AS IS", WITHOUT WARRANTY OF ANY KIND, EXPRESS OR IMPLIED,
INCLUDING BUT NOT LIMITED TO THE WARRANTIES OF MERCHANTABILITY, FITNESS FOR A
PARTICULAR PURPOSE AND NONINFRINGEMENT. IN NO EVENT SHALL THE AUTHORS OR COPYRIGHT
HOLDERS BE LIABLE FOR ANY CLAIM, DAMAGES OR OTHER LIABILITY, WHETHER IN AN ACTION
OF CONTRACT, TORT OR OTHERWISE, ARISING FROM, OUT OF OR IN CONNECTION WITH THE
SOFTWARE OR THE USE OR OTHER DEALINGS IN THE SOFTWARE. */

#include "SparkIntervalTimer.h"


// ------------------------------------------------------------
// static class variables need to be reiterated here before use
// ------------------------------------------------------------
bool IntervalTimer::SIT_used[];
IntervalTimer::ISRcallback IntervalTimer::SIT_CALLBACK[];

// ------------------------------------------------------------
// Define interval timer ISR hooks for three available timers
// TIM2...TIM7 with callbacks to user code.
// ------------------------------------------------------------
#if defined(STM32F10X_MD) || !defined(PLATFORM_ID)		//Core
void Wiring_TIM2_Interrupt_Handler_override()
{
	if (TIM_GetITStatus(TIM2, TIM_IT_Update) != RESET)
	{
		TIM_ClearITPendingBit(TIM2, TIM_IT_Update);
		IntervalTimer::SIT_CALLBACK[0]();
	}
}

void Wiring_TIM3_Interrupt_Handler_override()
{
	if (TIM_GetITStatus(TIM3, TIM_IT_Update) != RESET)
	{
		TIM_ClearITPendingBit(TIM3, TIM_IT_Update);
		IntervalTimer::SIT_CALLBACK[1]();
	}
}

void Wiring_TIM4_Interrupt_Handler_override()
{
	if (TIM_GetITStatus(TIM4, TIM_IT_Update) != RESET)
	{
		TIM_ClearITPendingBit(TIM4, TIM_IT_Update);
		IntervalTimer::SIT_CALLBACK[2]();
	}
}
#elif defined(STM32F2XX) && defined(PLATFORM_ID)	//Photon
void Wiring_TIM3_Interrupt_Handler_override()
{
	if (TIM_GetITStatus(TIM3, TIM_IT_Update) != RESET)
	{
		TIM_ClearITPendingBit(TIM3, TIM_IT_Update);
		IntervalTimer::SIT_CALLBACK[0]();
	}
}

void Wiring_TIM4_Interrupt_Handler_override()
{
	if (TIM_GetITStatus(TIM4, TIM_IT_Update) != RESET)
	{
		TIM_ClearITPendingBit(TIM4, TIM_IT_Update);
		IntervalTimer::SIT_CALLBACK[1]();
	}
}

void Wiring_TIM5_Interrupt_Handler_override()
{
	if (TIM_GetITStatus(TIM5, TIM_IT_Update) != RESET)
	{
		TIM_ClearITPendingBit(TIM5, TIM_IT_Update);
		IntervalTimer::SIT_CALLBACK[2]();
	}
}

void Wiring_TIM6_Interrupt_Handler_override()
{
	if (TIM_GetITStatus(TIM6, TIM_IT_Update) != RESET)
	{
		TIM_ClearITPendingBit(TIM6, TIM_IT_Update);
		IntervalTimer::SIT_CALLBACK[3]();
	}
}

void Wiring_TIM7_Interrupt_Handler_override()
{
	if (TIM_GetITStatus(TIM7, TIM_IT_Update) != RESET)
	{
		TIM_ClearITPendingBit(TIM7, TIM_IT_Update);
		IntervalTimer::SIT_CALLBACK[4]();
	}
}
#else
  #error "*** PARTICLE device not supported by this library. PLATFORM should be Core or Photon ***"
#endif

// ------------------------------------------------------------
// this function inits and starts the timer, using the specified
// function as a callback and the period provided. must be passed
// the name of a function taking no arguments and returning void.
// make sure this function can complete within the time allowed.
// attempts to allocate a timer using available resources,
// returning true on success or false in case of failure.
// Period units is defined by scale, where scale = uSec or hmSec
// and = 1-65535 microsecond (uSec)
// or 1-65535 0.5ms increments (hmSec)
// ------------------------------------------------------------
bool IntervalTimer::beginCycles(void (*isrCallback)(), intPeriod Period, bool scale, TIMid id) {

	// if this interval timer is already running, stop and deallocate it
	if (status == TIMER_SIT) {
		stop_SIT();
		status = TIMER_OFF;
	}
	// store callback pointer
	myISRcallback = isrCallback;

	if (id < NUM_SIT) {		// Allocate specified timer (id=0 to 2/4) or auto-allocate from pool (id=255)
		// attempt to allocate this timer
		if (allocate_SIT(Period, scale, id)) status = TIMER_SIT;		//255 means allocate from pool
		else status = TIMER_OFF;
	}
	else {
		// attempt to allocate this timer
		if (allocate_SIT(Period, scale, AUTO)) status = TIMER_SIT;		//255 means allocate from pool
		else status = TIMER_OFF;
	}

	// check for success and return
	if (status != TIMER_OFF) return true;
	return false;

}


// ------------------------------------------------------------
// enables the SIT clock if not already enabled, then checks to
// see if any SITs are available for use. if one is available,
// it's initialized and started with the specified value, and
// the function returns true, otherwise it returns false
// ------------------------------------------------------------
bool IntervalTimer::allocate_SIT(intPeriod Period, bool scale, TIMid id) {

	if (id < NUM_SIT) {		// Allocate specified timer (id=TIMER3/4/5) or auto-allocate from pool (id=AUTO)
		if (!SIT_used[id]) {
			SIT_id = id;
			start_SIT(Period, scale);
			SIT_used[id] = true;
			return true;
		}
	}
	else {
		// Auto allocate - check for an available SIT, and if so, start it
		for (uint8_t tid = 0; tid < NUM_SIT; tid++) {
			if (!SIT_used[tid]) {
				SIT_id = tid;
				start_SIT(Period, scale);
				SIT_used[tid] = true;
				return true;
			}
		}
	}

	// Specified or no auto-allocate SIT available
	return false;
}



// ------------------------------------------------------------
// configuters a SIT's TIMER registers, etc and enables
// interrupts, effectively starting the timer upon completion
// ------------------------------------------------------------
void IntervalTimer::start_SIT(intPeriod Period, bool scale) {

	TIM_TimeBaseInitTypeDef timerInitStructure;
    NVIC_InitTypeDef nvicStructure;
	intPeriod prescaler;
	TIM_TypeDef* TIMx;

	//use SIT_id to identify TIM#
	switch (SIT_id) {
#if defined(STM32F10X_MD) || !defined(PLATFORM_ID)		//Core
	case 0:		// TIM2
		RCC_APB1PeriphClockCmd(RCC_APB1Periph_TIM2, ENABLE);
		nvicStructure.NVIC_IRQChannel = TIM2_IRQn;
		TIMx = TIM2;
		break;
	case 1:		// TIM3
		RCC_APB1PeriphClockCmd(RCC_APB1Periph_TIM3, ENABLE);
		nvicStructure.NVIC_IRQChannel = TIM3_IRQn;
		TIMx = TIM3;
		break;
	case 2:		// TIM4
		RCC_APB1PeriphClockCmd(RCC_APB1Periph_TIM4, ENABLE);
		nvicStructure.NVIC_IRQChannel = TIM4_IRQn;
		TIMx = TIM4;
		break;
#elif defined(STM32F2XX) && defined(PLATFORM_ID)	//Photon
	case 0:		// TIM3
		RCC_APB1PeriphClockCmd(RCC_APB1Periph_TIM3, ENABLE);
		nvicStructure.NVIC_IRQChannel = TIM3_IRQn;
		TIMx = TIM3;
		break;
	case 1:		// TIM4
		RCC_APB1PeriphClockCmd(RCC_APB1Periph_TIM4, ENABLE);
		nvicStructure.NVIC_IRQChannel = TIM4_IRQn;
		TIMx = TIM4;
		break;
	case 2:		// TIM5
		RCC_APB1PeriphClockCmd(RCC_APB1Periph_TIM5, ENABLE);
		nvicStructure.NVIC_IRQChannel = TIM5_IRQn;
		TIMx = TIM5;
		break;
	case 3:		// TIM6
		RCC_APB1PeriphClockCmd(RCC_APB1Periph_TIM6, ENABLE);
		nvicStructure.NVIC_IRQChannel = TIM6_DAC_IRQn;
		TIMx = TIM6;
		break;
	case 4:		// TIM7
		RCC_APB1PeriphClockCmd(RCC_APB1Periph_TIM7, ENABLE);
		nvicStructure.NVIC_IRQChannel = TIM7_IRQn;
		TIMx = TIM7;
		break;
#endif
	}

	// Initialize Timer
	switch (scale) {
		case uSec:
			prescaler = SIT_PRESCALERu;	// Set prescaler for 1MHz clock, 1us period
			break;
		case hmSec:
			prescaler = SIT_PRESCALERm;	// Set prescaler for 2Hz clock, .5ms period
			break;
		default:
			prescaler = SIT_PRESCALERu;
			scale = uSec;				// Default to microseconds
			break;
	}

	// point to the correct SIT ISR
	SIT_CALLBACK[SIT_id] = myISRcallback;

	// Enable Timer Interrupt
    	nvicStructure.NVIC_IRQChannelPreemptionPriority = 10;
    	nvicStructure.NVIC_IRQChannelSubPriority = 1;
    	nvicStructure.NVIC_IRQChannelCmd = ENABLE;
    	NVIC_Init(&nvicStructure);

	// Timebase configuration
	timerInitStructure.TIM_Prescaler = prescaler;
	timerInitStructure.TIM_CounterMode = TIM_CounterMode_Up;
	timerInitStructure.TIM_Period = Period;
	timerInitStructure.TIM_ClockDivision = TIM_CKD_DIV1;
	timerInitStructure.TIM_RepetitionCounter = 0;

	TIM_TimeBaseInit(TIMx, &timerInitStructure);
	TIM_ITConfig(TIMx, TIM_IT_Update, ENABLE);
	TIM_Cmd(TIMx, ENABLE);
}


// ------------------------------------------------------------
// stop the timer if it's currently running, using its status
// to determine what hardware resources the timer may be using
// ------------------------------------------------------------
void IntervalTimer::end() {
	if (status == TIMER_SIT) stop_SIT();
	status = TIMER_OFF;
}


// ------------------------------------------------------------
// stops an active SIT by disabling its interrupt and TIMER
// and freeing up its state for future use.
// ------------------------------------------------------------
void IntervalTimer::stop_SIT() {

    NVIC_InitTypeDef nvicStructure;
	TIM_TypeDef* TIMx;


	//use SIT_id to identify TIM#
	switch (SIT_id) {
#if defined(STM32F10X_MD) || !defined(PLATFORM_ID)		//Core
	case 0:		// TIM2
		nvicStructure.NVIC_IRQChannel = TIM2_IRQn;
		TIMx = TIM2;
		break;
	case 1:		// TIM3
		nvicStructure.NVIC_IRQChannel = TIM3_IRQn;
		TIMx = TIM3;
		break;
	case 2:		// TIM4
		nvicStructure.NVIC_IRQChannel = TIM4_IRQn;
		TIMx = TIM4;
		break;
#elif defined(STM32F2XX) && defined(PLATFORM_ID)	//Photon
	case 0:		// TIM3
		nvicStructure.NVIC_IRQChannel = TIM3_IRQn;
		TIMx = TIM3;
		break;
	case 1:		// TIM4
		nvicStructure.NVIC_IRQChannel = TIM4_IRQn;
		TIMx = TIM4;
		break;
	case 2:		// TIM5
		nvicStructure.NVIC_IRQChannel = TIM5_IRQn;
		TIMx = TIM5;
		break;
	case 3:		// TIM6
		nvicStructure.NVIC_IRQChannel = TIM6_DAC_IRQn;
		TIMx = TIM6;
		break;
	case 4:		// TIM7
		nvicStructure.NVIC_IRQChannel = TIM7_IRQn;
		TIMx = TIM7;
		break;
#endif
		}
	// disable counter
	TIM_Cmd(TIMx, DISABLE);

	// disable interrupt
    nvicStructure.NVIC_IRQChannelCmd = DISABLE;
    NVIC_Init(&nvicStructure);

	// disable timer peripheral
	TIM_DeInit(TIMx);

	// free SIT for future use
	SIT_used[SIT_id] = false;
}


// ------------------------------------------------------------
// Enables or disables an active SIT's interrupt without
// removing the SIT.
// ------------------------------------------------------------
void IntervalTimer::interrupt_SIT(action ACT)
{
    NVIC_InitTypeDef nvicStructure;
	TIM_TypeDef* TIMx;

	//use SIT_id to identify TIM#
	switch (SIT_id) {
#if defined(STM32F10X_MD) || !defined(PLATFORM_ID)		//Core
	case 0:		// TIM2
		nvicStructure.NVIC_IRQChannel = TIM2_IRQn;
		TIMx = TIM2;
		break;
	case 1:		// TIM3
		nvicStructure.NVIC_IRQChannel = TIM3_IRQn;
		TIMx = TIM3;
		break;
	case 2:		// TIM4
		nvicStructure.NVIC_IRQChannel = TIM4_IRQn;
		TIMx = TIM4;
		break;
#elif defined(STM32F2XX) && defined(PLATFORM_ID)	//Photon
	case 0:		// TIM3
		nvicStructure.NVIC_IRQChannel = TIM3_IRQn;
		TIMx = TIM3;
		break;
	case 1:		// TIM4
		nvicStructure.NVIC_IRQChannel = TIM4_IRQn;
		TIMx = TIM4;
		break;
	case 2:		// TIM5
		nvicStructure.NVIC_IRQChannel = TIM5_IRQn;
		TIMx = TIM5;
		break;
	case 3:		// TIM6
		nvicStructure.NVIC_IRQChannel = TIM6_DAC_IRQn;
		TIMx = TIM6;
		break;
	case 4:		// TIM7
		nvicStructure.NVIC_IRQChannel = TIM7_IRQn;
		TIMx = TIM7;
		break;
#endif
	}

	switch (ACT) {
	case INT_ENABLE:
		//Enable Timer Interrupt
		nvicStructure.NVIC_IRQChannelPreemptionPriority = 0;
		nvicStructure.NVIC_IRQChannelSubPriority = 1;
		nvicStructure.NVIC_IRQChannelCmd = ENABLE;
		NVIC_Init(&nvicStructure);
		break;
	case INT_DISABLE:
		// disable interrupt
		nvicStructure.NVIC_IRQChannelCmd = DISABLE;
		NVIC_Init(&nvicStructure);
		break;
	default:
		//Do nothing
		break;
	}
}


// ------------------------------------------------------------
// Set new period for the SIT without
// removing the SIT.
// ------------------------------------------------------------
void IntervalTimer::resetPeriod_SIT(intPeriod newPeriod, bool scale)
{
	//TIM_TimeBaseInitTypeDef timerInitStructure;
	TIM_TypeDef* TIMx;
	intPeriod prescaler;

	//use SIT_id to identify TIM#
	switch (SIT_id) {
#if defined(STM32F10X_MD) || !defined(PLATFORM_ID)		//Core
	case 0:		// TIM2
		TIMx = TIM2;
		break;
	case 1:		// TIM3
		TIMx = TIM3;
		break;
	case 2:		// TIM4
		TIMx = TIM4;
		break;
#elif defined(STM32F2XX) && defined(PLATFORM_ID)	//Photon
	case 0:		// TIM3
		TIMx = TIM3;
		break;
	case 1:		// TIM4
		TIMx = TIM4;
		break;
	case 2:		// TIM5
		TIMx = TIM5;
		break;
	case 3:		// TIM6
		TIMx = TIM6;
		break;
	case 4:		// TIM7
		TIMx = TIM7;
		break;
#endif
	}

	switch (scale) {
	case uSec:
		prescaler = SIT_PRESCALERu;	// Set prescaler for 1MHz clock, 1us period
		break;
	case hmSec:
		prescaler = SIT_PRESCALERm;	// Set prescaler for 2Hz clock, .5ms period
		break;
	default:
		scale = uSec;				// Default to microseconds
		prescaler = SIT_PRESCALERu;
		break;
	}

	TIMx->ARR = newPeriod;
	TIMx->PSC = prescaler;
	TIMx->EGR = TIM_PSCReloadMode_Immediate;
	TIM_ClearITPendingBit(TIMx, TIM_IT_Update);
}

// ------------------------------------------------------------
// Returns -1 if timer not allocated or sid number:
// 0 = TMR2, 1 = TMR3, 2 = TMR4
// ------------------------------------------------------------
int8_t IntervalTimer::isAllocated_SIT(void)
{
	if (status == TIMER_SIT)
		return -1;
	else
		return SIT_id;
}
