davegutz/myThermostat-Particle-Photon/myThermostat_Particle_DEV/BlynkParam.h

/**
 * @file       BlynkParam.h
 * @author     Volodymyr Shymanskyy
 * @license    This project is released under the MIT License (MIT)
 * @copyright  Copyright (c) 2015 Volodymyr Shymanskyy
 * @date       Jan 2015
 * @brief      Container for handler parameters
 *
 */

#ifndef BlynkParam_h
#define BlynkParam_h

#include <string.h>
#include <stdlib.h>
//#include <Blynk/BlynkConfig.h>
//#include <Blynk/BlynkDebug.h>
#include "BlynkConfig.h"
#include "BlynkDebug.h"

#define BLYNK_PARAM_KV(k, v) k "\0" v "\0"

class BlynkParam
{
public:
    class iterator
    {
    public:
        iterator(char* c) : ptr(c) {}
        static iterator invalid() { return iterator(NULL); }

        operator const char* () const   { return asStr(); }
        operator int () const           { return asInt(); }
        const char* asStr() const       { return ptr; }
        const char* asString() const    { return ptr; }
        int         asInt() const       { return atoi(ptr); }
        long        asLong() const      { return atol(ptr); }
#ifndef BLYNK_NO_FLOAT
        double      asDouble() const    { return atof(ptr); }
#endif
        bool isValid() const            { return ptr != NULL; }

        bool operator <  (const iterator& it) const { return ptr < it.ptr; }
        bool operator >= (const iterator& it) const { return ptr >= it.ptr; }

        iterator& operator ++() {
            ptr += strlen(ptr)+1;
            return *this;
        }
    private:
        const char* ptr;
    };

public:
    explicit
    BlynkParam(void* addr, size_t length)
        : buff((char*)addr), len(length), buff_size(length)
    {}

    explicit
    BlynkParam(void* addr, size_t length, size_t buffsize)
        : buff((char*)addr), len(length), buff_size(buffsize)
    {}

    const char* asStr() const       { return buff; }
    const char* asString() const    { return buff; }
    int         asInt() const       { return atoi(buff); }
    long        asLong() const      { return atol(buff); }
#ifndef BLYNK_NO_FLOAT
    double      asDouble() const    { return atof(buff); }
#endif

    iterator begin() const { return iterator(buff); }
    iterator end() const   { return iterator(buff+len); }

    iterator operator[](int index) const;
    iterator operator[](const char* key) const;

    void*  getBuffer() const { return (void*)buff; }
    size_t getLength() const { return len; }

    // Modification
    void add(int value);
    void add(unsigned int value);
    void add(long value);
    void add(unsigned long value);
#ifndef BLYNK_NO_FLOAT
    void add(float value);
    void add(double value);
#endif
    void add(const char* str);
    void add(const void* b, size_t l);
#if defined(ARDUINO) || defined(SPARK) || defined(PARTICLE)
    void add(const String& str);
    void add(String& str);
#endif

    template <typename TV>
    void add_key(const char* key, const TV& val) {
        add(key);
        add(val);
    }

private:
    char*	buff;
    size_t	len;
    size_t	buff_size;
};

inline
BlynkParam::iterator BlynkParam::operator[](int index) const
{
    const iterator e = end();
    for (iterator it = begin(); it < e; ++it) {
        if (!index--) {
            return it;
        }
    }
    return iterator::invalid();
}

inline
BlynkParam::iterator BlynkParam::operator[](const char* key) const
{
    const iterator e = end();
    for (iterator it = begin(); it < e; ++it) {
        if (!strcmp(it.asStr(), key)) {
            return ++it;
        }
        ++it;
        if (it >= e) break;
    }
    return iterator::invalid();
}

inline
void BlynkParam::add(const void* b, size_t l)
{
    if (len + l > buff_size)
        return;
    memcpy(buff+len, b, l);
    len += l;
}

inline
void BlynkParam::add(const char* str)
{
    add(str, strlen(str)+1);
}

#if defined(ARDUINO) || defined(SPARK) || defined(PARTICLE)
inline
void BlynkParam::add(const String& str)
{
    size_t len = str.length()+1;
    char buff[len];
#if defined(ARDUINO_AVR_DIGISPARK)
    const_cast<String&>(str).toCharArray(buff, len);
#else
    str.toCharArray(buff, len);
#endif
    BlynkParam::add(buff, len);
}

inline
void BlynkParam::add(String& str)
{
    size_t len = str.length()+1;
    char buff[len];
    str.toCharArray(buff, len);
    BlynkParam::add(buff, len);
}
#endif

#if defined(__AVR__) || defined (ARDUINO_ARCH_ARC32)

    #include <stdlib.h>

	inline
    void BlynkParam::add(int value)
    {
        char str[2 + 8 * sizeof(value)];
        itoa(value, str, 10);
        add(str);
    }

	inline
    void BlynkParam::add(unsigned int value)
    {
        char str[1 + 8 * sizeof(value)];
        utoa(value, str, 10);
        add(str);
    }

	inline
    void BlynkParam::add(long value)
    {
        char str[2 + 8 * sizeof(value)];
        ltoa(value, str, 10);
        add(str);
    }

	inline
    void BlynkParam::add(unsigned long value)
    {
        char str[1 + 8 * sizeof(value)];
        ultoa(value, str, 10);
        add(str);
    }

#ifndef BLYNK_NO_FLOAT

	inline
    void BlynkParam::add(float value)
    {
        char str[33];
        dtostrf(value, 5, 3, str);
        add(str);
    }

	inline
    void BlynkParam::add(double value)
    {
        char str[33];
        dtostrf(value, 5, 3, str);
        add(str);
    }
#endif

#else

    #include <stdio.h>

	inline
    void BlynkParam::add(int value)
    {
        len += snprintf(buff+len, buff_size-len, "%i", value)+1;
    }

	inline
    void BlynkParam::add(unsigned int value)
    {
        len += snprintf(buff+len, buff_size-len, "%u", value)+1;
    }

	inline
    void BlynkParam::add(long value)
    {
        len += snprintf(buff+len, buff_size-len, "%li", value)+1;
    }

	inline
    void BlynkParam::add(unsigned long value)
    {
        len += snprintf(buff+len, buff_size-len, "%lu", value)+1;
    }

#ifndef BLYNK_NO_FLOAT

#if defined(ESP8266)

	extern char* dtostrf_internal(double number, signed char width, unsigned char prec, char *s);

	inline
    void BlynkParam::add(float value)
    {
        char str[33];
        dtostrf_internal(value, 5, 3, str);
        add(str);
    }

	inline
    void BlynkParam::add(double value)
    {
        char str[33];
        dtostrf_internal(value, 5, 3, str);
        add(str);
    }

#else

	inline
    void BlynkParam::add(float value)
    {
        len += snprintf(buff+len, buff_size-len, "%2.3f", value)+1;
    }

	inline
    void BlynkParam::add(double value)
    {
        len += snprintf(buff+len, buff_size-len, "%2.3f", value)+1;
    }

#endif

#endif

#endif


#endif
