davegutz/myThermostat-Particle-Photon/myThermostat_Particle_DEV/adafruit-gfx.h

#ifndef _ADAFRUIT_GFX_H
#define _ADAFRUIT_GFX_H

#ifdef SPARK
 #include "application.h"
#elif ARDUINO >= 100
 #include "Arduino.h"
 #include "Print.h"
#else
 #include "WProgram.h"
#endif

#ifndef B00000000
#define B00000000 0
#define B00000001 1
#define B00000010 2
#define B00000011 3
#define B00000100 4
#define B00000101 5
#define B00000110 6
#define B00000111 7
#define B00001000 8
#define B00001001 9
#define B00001010 10
#define B00001011 11
#define B00001100 12
#define B00001101 13
#define B00001110 14
#define B00001111 15
#define B00010000 16
#define B00010001 17
#define B00010010 18
#define B00010011 19
#define B00010100 20
#define B00010101 21
#define B00010110 22
#define B00010111 23
#define B00011000 24
#define B00011001 25
#define B00011010 26
#define B00011011 27
#define B00011100 28
#define B00011101 29
#define B00011110 30
#define B00011111 31
#define B00100000 32
#define B00100001 33
#define B00100010 34
#define B00100011 35
#define B00100100 36
#define B00100101 37
#define B00100110 38
#define B00100111 39
#define B00101000 40
#define B00101001 41
#define B00101010 42
#define B00101011 43
#define B00101100 44
#define B00101101 45
#define B00101110 46
#define B00101111 47
#define B00110000 48
#define B00110001 49
#define B00110010 50
#define B00110011 51
#define B00110100 52
#define B00110101 53
#define B00110110 54
#define B00110111 55
#define B00111000 56
#define B00111001 57
#define B00111010 58
#define B00111011 59
#define B00111100 60
#define B00111101 61
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
#define B11111010 250
#define B11111011 251
#define B11111100 252
#define B11111101 253
#define B11111110 254
#define B11111111 255
#endif
#define swap(a, b) { int16_t t = a; a = b; b = t; }

class Adafruit_GFX : public Print {

 public:

  Adafruit_GFX(int16_t w, int16_t h); // Constructor

  // This MUST be defined by the subclass:
  virtual void drawPixel(int16_t x, int16_t y, uint16_t color) = 0;

  // These MAY be overridden by the subclass to provide device-specific
  // optimized code.  Otherwise 'generic' versions are used.
  virtual void
    drawLine(int16_t x0, int16_t y0, int16_t x1, int16_t y1, uint16_t color),
    drawFastVLine(int16_t x, int16_t y, int16_t h, uint16_t color),
    drawFastHLine(int16_t x, int16_t y, int16_t w, uint16_t color),
    drawRect(int16_t x, int16_t y, int16_t w, int16_t h, uint16_t color),
    fillRect(int16_t x, int16_t y, int16_t w, int16_t h, uint16_t color),
    fillScreen(uint16_t color),
    invertDisplay(boolean i);

  // These exist only with Adafruit_GFX (no subclass overrides)
  void
    drawCircle(int16_t x0, int16_t y0, int16_t r, uint16_t color),
    drawCircleHelper(int16_t x0, int16_t y0, int16_t r, uint8_t cornername,
      uint16_t color),
    fillCircle(int16_t x0, int16_t y0, int16_t r, uint16_t color),
    fillCircleHelper(int16_t x0, int16_t y0, int16_t r, uint8_t cornername,
      int16_t delta, uint16_t color),
    drawTriangle(int16_t x0, int16_t y0, int16_t x1, int16_t y1,
      int16_t x2, int16_t y2, uint16_t color),
    fillTriangle(int16_t x0, int16_t y0, int16_t x1, int16_t y1,
      int16_t x2, int16_t y2, uint16_t color),
    drawRoundRect(int16_t x0, int16_t y0, int16_t w, int16_t h,
      int16_t radius, uint16_t color),
    fillRoundRect(int16_t x0, int16_t y0, int16_t w, int16_t h,
      int16_t radius, uint16_t color),
    drawBitmap(int16_t x, int16_t y, const uint8_t *bitmap,
      int16_t w, int16_t h, uint16_t color),
    drawBitmap(int16_t x, int16_t y, const uint8_t *bitmap,
      int16_t w, int16_t h, uint16_t color, uint16_t bg),
    drawXBitmap(int16_t x, int16_t y, const uint8_t *bitmap,
      int16_t w, int16_t h, uint16_t color),
    drawChar(int16_t x, int16_t y, unsigned char c, uint16_t color,
      uint16_t bg, uint8_t size),
    setCursor(int16_t x, int16_t y),
    setTextColor(uint16_t c),
    setTextColor(uint16_t c, uint16_t bg),
    setTextSize(uint8_t s),
    setTextWrap(boolean w),
    setRotation(uint8_t r);

#ifdef SPARK
  virtual size_t write(uint8_t);
#elif ARDUINO >= 100
  virtual size_t write(uint8_t);
#else
  virtual void   write(uint8_t);
#endif

  int16_t height(void) const;
  int16_t width(void) const;

  uint8_t getRotation(void) const;

 protected:
  const int16_t
    WIDTH, HEIGHT;   // This is the 'raw' display w/h - never changes
  int16_t
    _width, _height, // Display w/h as modified by current rotation
    cursor_x, cursor_y;
  uint16_t
    textcolor, textbgcolor;
  uint8_t
    textsize,
    rotation;
  boolean
    wrap; // If set, 'wrap' text at right edge of display
};

#endif // _ADAFRUIT_GFX_H
