davegutz/myThermostat-Particle-Photon/myThermostat_Particle_DEV/myAuth.h

#ifndef myAuth_h
#define myAuth_h
#ifndef BARE_PHOTON
    const   String    blynkAuth  = "4f1de4949e4c4020882efd3e61bdd6cd"; // PhotonTHermo9HYK thermostat
#else
    const   String    blynkAuth  = "d2140898f7b94373a7868f158a3403a1"; // PhotonExp9HYK unconnected photon
#endif
#endif
