davegutz/myThermostat-Particle-Photon/(commit log)

2015-11-11 Initial submittal
    [PhotonThermostatLayout.ods, PhotonThermostatLayout.xlsx]
2015-11-14 randomly move the inactive 'dot' and 'plus' signs around to preserve life of LEDs.
2015-11-14 fix merge of last commit
    [pixmaps.cpp]
2015-11-14 prototype of webhook for OAT
2015-12-04 UL all time counters (fix for breathing green?)
    [myThermostat.ino]
2015-12-13 SYSTEM_THREAD(ENABLED) and Particle.Process()
    Attempt to correct flashing green mode after many days of operation.
    [myAuth.h, myThermostat.ino]
2015-12-14 Continue to debug sync issues - bad timer
    Delete connection timer: it was using integer count threshold that was
    larger than data type uint16_t allows. Maybe causing problem when
    timer exercised (saw T=6 on Blynk before lock into blinking cyan mode).
    [myThermostat.ino]
2015-12-18 Fix Rapid Flashing Cyan
    An errant character string pointer caused various nasty side effects
    including freezing up the thermostat in the middle of the night. I
    tried to replace all occurrences of char* and char[] with String class
    variables. Along the way I added some #defines that make some
    interesting run configurations.
    [BlynkProtocol.h, myAuth.h, myThermostat.ino, openweathermap.cpp, openweathermap.h]
2015-12-23 String Reserve Space Too Small
    Had one more flashing cyan hangup. Possibly caused by bad
    statStr.reserve(80). We'll see.
    [myThermostat.ino]
2015-12-28 Another Memory Leak Workaround- rapid flashing cyan
    The openweathermap functions generate a memory leak in the json parsing
    functions. I do not understand why yet so I left a flag in that
    purposely generates the leak (WEATHER_BUG) and instructions how to
    recreate it (comment out NO_WEATHER l ine in .ino.) Can speed up the
    bug demo by setting QUERY_DELAY = 100. Results in rapid flashing cyan.
    Default is to turn WEATHER off which turns off recovery feature for cold
    days (not a deal breaker by any means).
    [myThermostat.ino, openweathermap.cpp, openweathermap.h]
2015-12-28 Fix Previous Commit
    Forgot to size template in a way that will reproduce the memory
    problems. openweathermap.h
    [openweathermap.h]
2016-01-01 Working Version of OAT Webhook
    I am replacing the bad json - based openweathermap code with a simple
    webhook to cure memory management problems that cause blinking cyan.
    It's working well so far. Next I'll remove the json code.
    [myThermostat.ino]
2016-01-01 Beautified the Display
    It now cycles through the setpoint, temp, oat, and hum at the LED. I
    left the openweathermap code in but left out of compilation by #ifndef
    statement.
2016-01-08 Rate Compensation
    Added temperature rate compensation to lessen overshoots
    [myFilters.cpp, myFilters.h, myThermostat.ino]
2016-01-09 Couple Typos
    typos
2016-01-10 Delete openweathermap Content
    This code, including a simple json library, caused memory leaks and
    Photon freezes and has been deleted in favor of webhooks which are
    simpler anyway.
    [JsonArray.cpp, JsonArray.h, JsonHashTable.cpp, JsonHashTable.h, JsonObjectBase.cpp, JsonObjectBase.h, JsonParser.h, myAuth.h]
2016-01-10 Cleanup
    Make update time of filter same as sensor reads to cleanup noise in
    display.
    [myThermostat.ino]
2016-01-17 Delete Spark Time for Stability
    Delete rtc functions and udp. Should make more stable.
    [mySubs.cpp, mySubs.h, myThermostat.ino]
2016-01-17 Finished Cleanup
    You cannot move interrupt timer stuff out of main.ino
2016-01-17 Initial Interrupt Driven Control
    still need sensing
2016-01-17 Revert "Initial Interrupt Driven Control"
    This reverts commit 130c27eea896309c933438acf33a2823089ebad2.
    [mySubs.h, myThermostat.ino]
2016-01-18 Debug External variables
    Broke externs by renaming them static. Revert
    [mySubs.cpp, mySubs.h, myThermostat.ino]
2016-01-22 Another bug, and refine model
    tmpsStr was too small. Made it 140. Caused crashes?
    Also made model better and run BARE_PHOTON like house.
    [myFilters.cpp, myFilters.h, mySubs.cpp, mySubs.h, myThermostat.ino]
2016-01-24 Time Shift Fix
    Spark Time starts counting from 1 not zero.
    [thermo20160121.xlsx, thermo20160123.xlsx]
2016-01-27 Prep for Observer Filter
    Name changes
    [thermo20160123.xlsx]
2016-01-27 Schematics Added
    Simulink model
2016-01-27 Add Observer Filter
2016-01-28 Revise Filter Analysis
    New filter: PI on temp error not rate.
2016-01-29 Final Observer Config
    Should check plots to be sure
    [thermo20160128a.xlsx]
2016-01-30 Progress House Model Object
    [thermo20160130.xlsx]
2016-01-30 Use Tracker for Bare Photon Too
    Used new house class.
    [thermo20160128a.xlsx, thermo20160130.xlsx]
2016-01-31 Cosmetic
    Eliminate global variables as much as possible
    [exp20160130.xlsx, exp20160131.xlsx]
2016-02-01 Fix Limits in Tracker
    Integrator could wind up before limits changed. May have explained
    oscillation seen in Exp version (BARE_PHOTON)
    [thermo20160130.xlsx]
2016-05-26 Update Blynk from 0.3.2 to 0.3.7 after outage.
    Blynk had server outage. Upon restart, old software does not work.
    Downloaded entire blynk-library and hand-copied file by file over (18)
    and changed paths to headers in those 18.
    [BlynkApi.h, BlynkApiParticle.h, BlynkConfig.h, BlynkDebug.cpp, BlynkDebug.h, BlynkHandlers.cpp, BlynkHandlers.h, BlynkParam.h]
2016-11-27 Fix Daylight Savings Time Calculation
    [mySubs.cpp]
